fl0m0/EFM8_USB_Debug_Adapter/doc/bestellen.md

* Anschlussklemmen
  * Metz Connect [31230102](https://www.reichelt.de/index.html?ACTION=446&LA=3&nbc=1&q=31230102) und [31249102](https://www.reichelt.de/index.html?ACTION=446&LA=446&nbc=1&q=31249102)
* Magnet: https://www.reichelt.de/magnete-c7619.html?&nbc=1
* Hohlstecker [DELOCK 89910](https://www.reichelt.de/steckverbinder-dc-buchse-zum-einbau-delock-89910-p259482.html?&trstct=pol_7&nbc=1)
* Wannenstecker

  * [WSL 10W](https://www.reichelt.de/wannenstecker-10-polig-gewinkelt-wsl-10w-p22818.html?&trstct=pos_0&nbc=1)

  * [WSL 6W](https://www.reichelt.de/wannenstecker-6-polig-gewinkelt-wsl-6w-p105978.html?search=wsl6w)
* Jumper [BKL 10120906](https://www.reichelt.de/kodierbruecken-set-blau-schwarz-rot-bkl-10120906-p235670.html?&trstct=pol_4&nbc=1)
* Stiftleiste 36-polig [W+P 946-14-036](https://www.reichelt.de/stiftleiste-rm-2-54mm-gewinkelt-1-reihig-36-polig-w-p-946-14-036-p330986.html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)
* Crimpzange
  * Iwiss 3220M
  * Für Aderendhülsen
  * Crimpkontakte
* Lötpaste, z.B. Chipquick [TS391SNL10](https://www.digikey.de/de/products/detail/chip-quik-inc/TS391SNL10/7802216) (bei Raumtemperatur lagerbar)
* [USB-Stick](https://www.reichelt.de/usb-stick-usb-3-1-128-gb-ultra-fit-sdcz430-128g-g46-p222575.html?&trstct=pos_27&nbc=1) für Fritz!Box
* [Thermo- / Hygrometer](https://www.reichelt.de/thermo-hygrometer-tfa-30505102-p288520.html?&trstct=pos_17&nbc=1)
* [UJC-HP-G-5-SMT-TR](https://www.cuidevices.com/product/interconnect/connectors/usb-connectors/ujc-hp-g-5-smt-tr), besser[USB4135-GF-A](https://www.digikey.de/en/products/detail/gct/USB4135-GF-A/16036137) da lieferbar
* BNC-Kabel
  * [T-Stück](https://www.reichelt.de/adapter-bnc-t-stueck-50-ohm-bkl-0401169-p280451.html?&trstct=pos_23&nbc=1)
  * [Terminalblock](https://www.reichelt.de/bnc-stecker-terminalblock-2-pin-delock-65525-p143220.html?&trstct=pos_9&nbc=1)
  * [BNC-Stecker-Kappe](https://www.reichelt.de/bnc-stecker-kappe-ohne-kette-r141-802-p120895.html?&trstct=pol_4&nbc=1)
  * [BNC-Adapter](https://www.reichelt.de/bnc-adapter-bnc-stecker-2x-polklemme-ge-860-p8153.html?&trstct=pol_31&nbc=1)
  * [50 Ohm](https://www.reichelt.de/bnc-abschlussstecker-50-ohm-ug-88-50-p22035.html?&nbc=1&trstct=lsbght_sldr::8153)
  * [9 V Block](https://www.reichelt.de/hycell-nimh-akku-9-v-block-180-mah-1er-pack-ans-hc-9v-180-p334542.html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)
  *
