fl0m0/EFM8_USB_Debug_Adapter/doc/Design_Notes_B1.md

* Improved ideal diode from https://hardware.buspirate.com/#programmable-power-supply-unit
* Isolated communication interface
  * [ADuM1253](https://www.analog.com/media/en/technical-documentation/data-sheets/adum1253.pdf) for C2 interface
  * [ADuM5211](https://www.analog.com/media/en/technical-documentation/data-sheets/ADuM5210_5211_5212.pdf) for UART
  * 

* UART RX/TX LED indicator
