fl0m0/EFM8_USB_Debug_Adapter/mech/Case/USB_CON_Light_Pipe.step

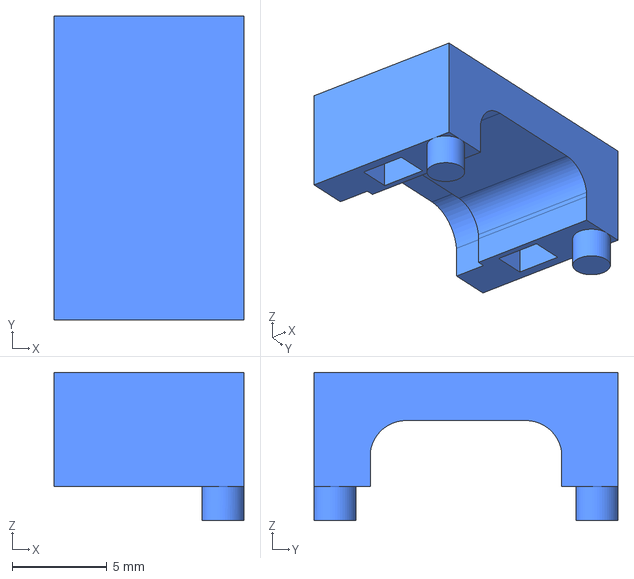
[picture p1: CAD file, 2024-02-17]
mech/Case/USB_CON_Light_Pipe.step
10.0 x 16.0 x 7.80 mm
