fl0m0/EFM8_USB_Debug_Adapter/mech/Case/EFM8_USB_Debug_Adapter_Case_A1.FCStd

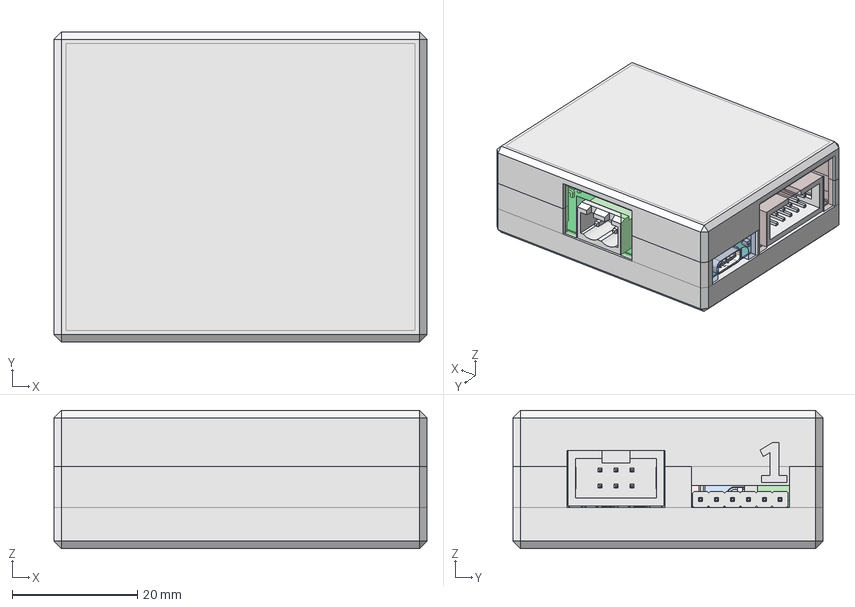
[picture p3: CAD file, 2024-02-17]
mech/Case/EFM8_USB_Debug_Adapter_Case_A1.FCStd
59.6 x 49.6 x 22.1 mm
Pcb_1969
J100_IDC_Header_2x03_P254mm_Horizontal_0b07955c75c3
R115_R_0603_1608Metric_40ce69eb2c34 x 14
D120_LED_0805_2012Metric_de8e61f5e2f3 x 6
M130_DBG8 CON - Body002_e8fd90211a46
Q121_SOT_23_6_8a3c9792cae7 x 6
J130_IDC_Header_2x05_P254mm_Horizontal_2f630b54ad9b
J111_PinHeader_1x06_P254mm_Horizontal_3895f87b3638
M110_USB CON - Body004_d89be29e0cf2
J120_MSTBA_01x02_G_5_08mm_f78722a1ad4a
F110_Fuse_1206_3216Metric_44d931e7ee9a
M120_PSU CON - Body003_f36d153cdec4
J131_PinHeader_1x02_P254mm_Vertical_49238c3e1f2a
Bottom - Body
Top - Body001
