fl0m0/EFM8_USB_Debug_Adapter/mech/Case/EFM8_USB_Debug_Adapter_Case_A1-PartBottom.stl

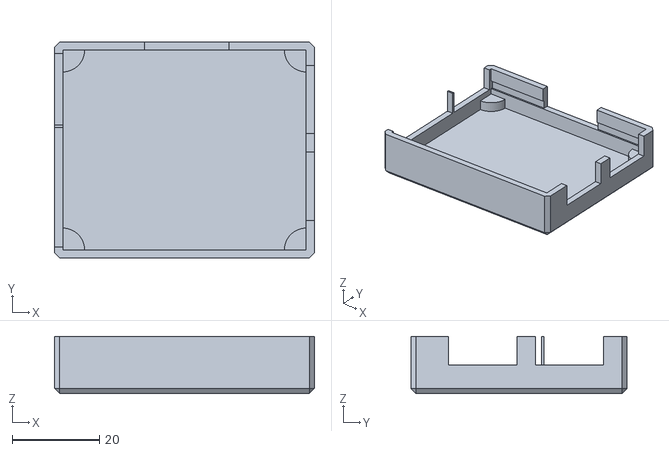
[picture p4: CAD file, 2024-02-17]
mech/Case/EFM8_USB_Debug_Adapter_Case_A1-PartBottom.stl
59.6 x 49.6 x 13.1
