fl0m0/EFM8_USB_Debug_Adapter/mech/Case/EFM8_Light_Pipes.3mf

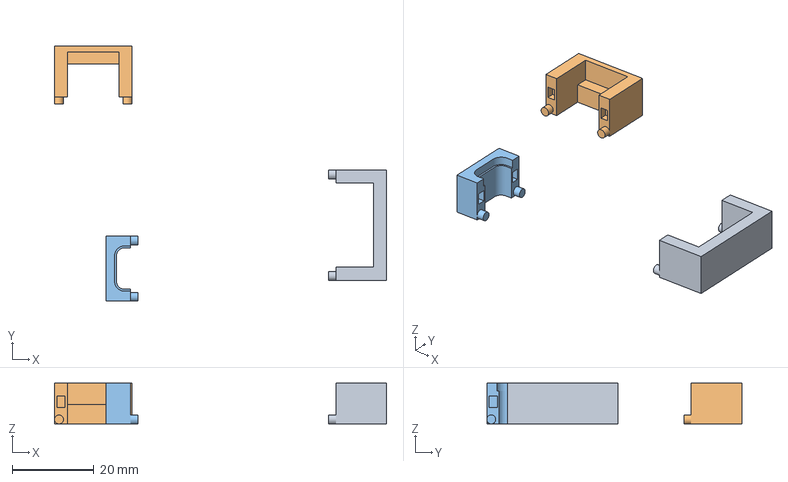
[picture p5: CAD file, 2024-02-17]
mech/Case/EFM8_Light_Pipes.3mf
81.3 x 62.5 x 10.0 mm
DBG8_CON_Light_Pipe.stl
PSU_CON_Light_Pipe.stl
USB_CON_Light_Pipe.stl
