fl0m0/EFM8_USB_Debug_Adapter/mech/Case/PSU_CON_Light_Pipe.step

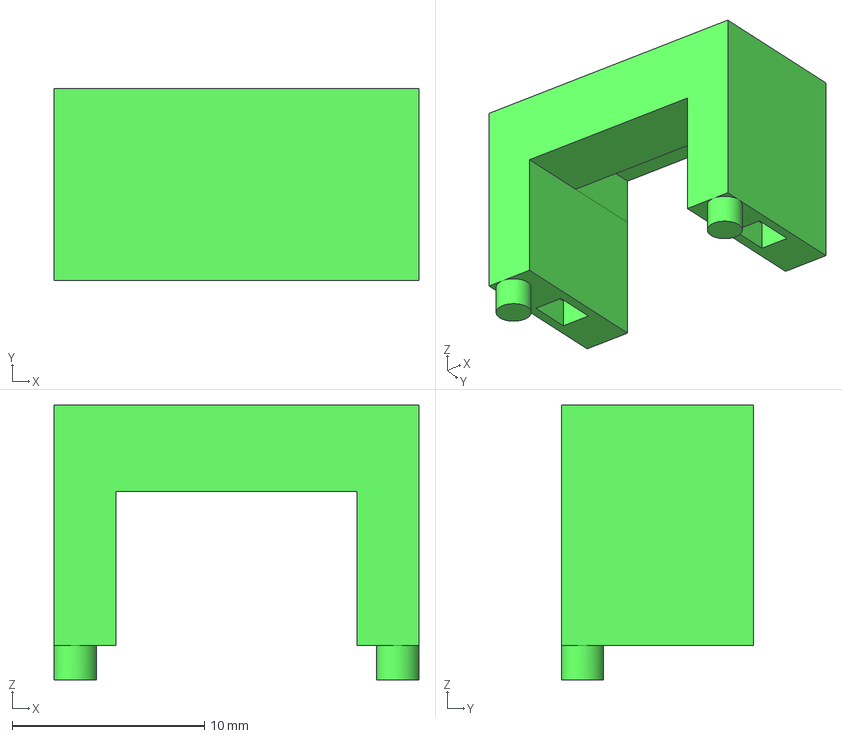
[picture p6: CAD file, 2024-02-17]
mech/Case/PSU_CON_Light_Pipe.step
19.0 x 10.0 x 14.3 mm
