fl0m0/EFM8_USB_Debug_Adapter/mech/Case/DBG8_CON_Light_Pipe.step

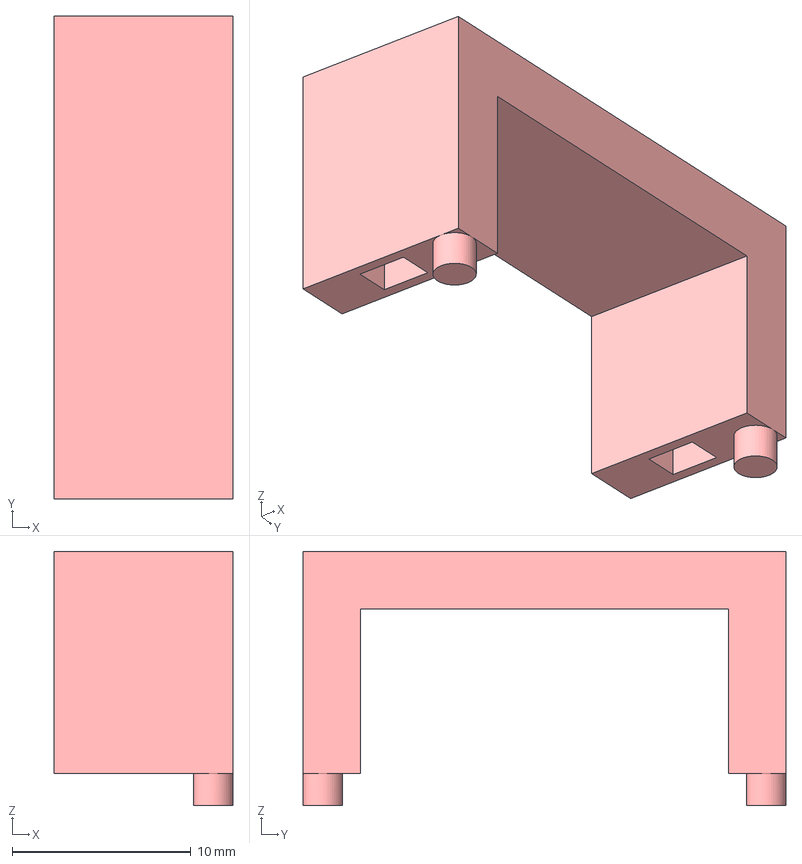
[picture p8: CAD file, 2024-02-17]
mech/Case/DBG8_CON_Light_Pipe.step
10.0 x 27.0 x 14.2 mm
