fl0m0/EFM8_USB_Debug_Adapter/mech/Case/EFM8_USB_Debug_Adapter_Case_A1-Logo.stl

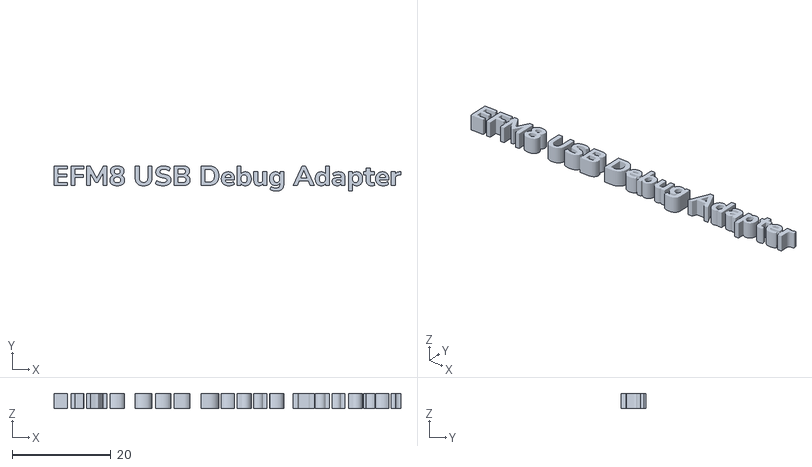
[picture p9: CAD file, 2024-02-17]
mech/Case/EFM8_USB_Debug_Adapter_Case_A1-Logo.stl
70.2 x 5.10 x 3.00
