fl0m0/EFM8_USB_Debug_Adapter/mech/Case/3D_31249102_1.stp

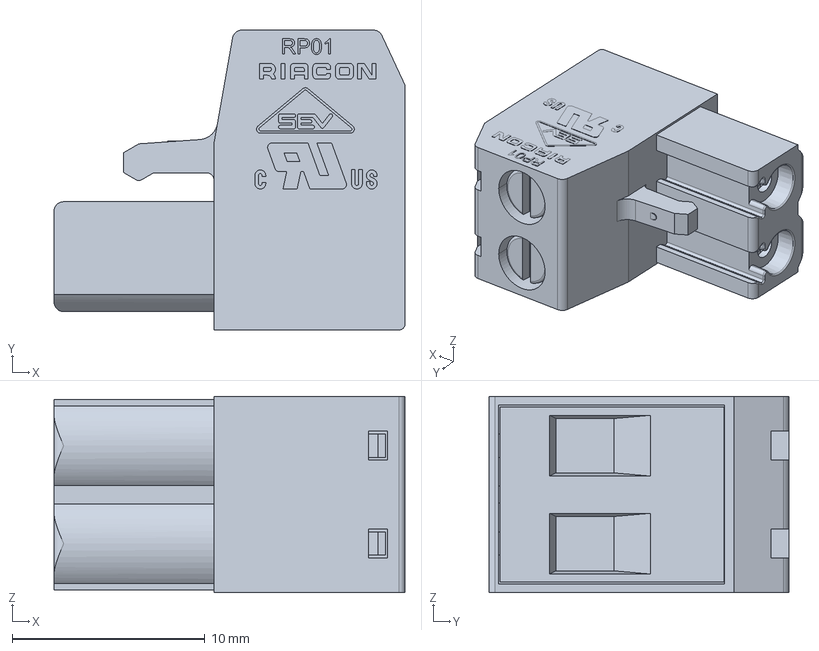
[picture p10: CAD file, 2022-11-03]
mech/Case/3D_31249102_1.stp
18.2 x 15.6 x 10.2 mm
