fl0m0/EFM8_USB_Debug_Adapter/(list of files, cad)

Other CAD files:
mech/Case/DBG8_CON_Light_Pipe.dxf
mech/Case/DBG8_CON_Light_Pipe.stl
mech/Case/EFM8_USB_Debug_Adapter_Case_A1.3mf
mech/Case/PSU_CON_Light_Pipe.dxf
mech/Case/PSU_CON_Light_Pipe.stl
mech/Case/USB_CON_Light_Pipe.dxf
mech/Case/USB_CON_Light_Pipe.stl
