fl0m0/EFM8_USB_Debug_Adapter/pcb/EFM8_USB_Debug_Adapter/B1/fabrication_output/EFM8_USB_Debug_Adapter.pdf

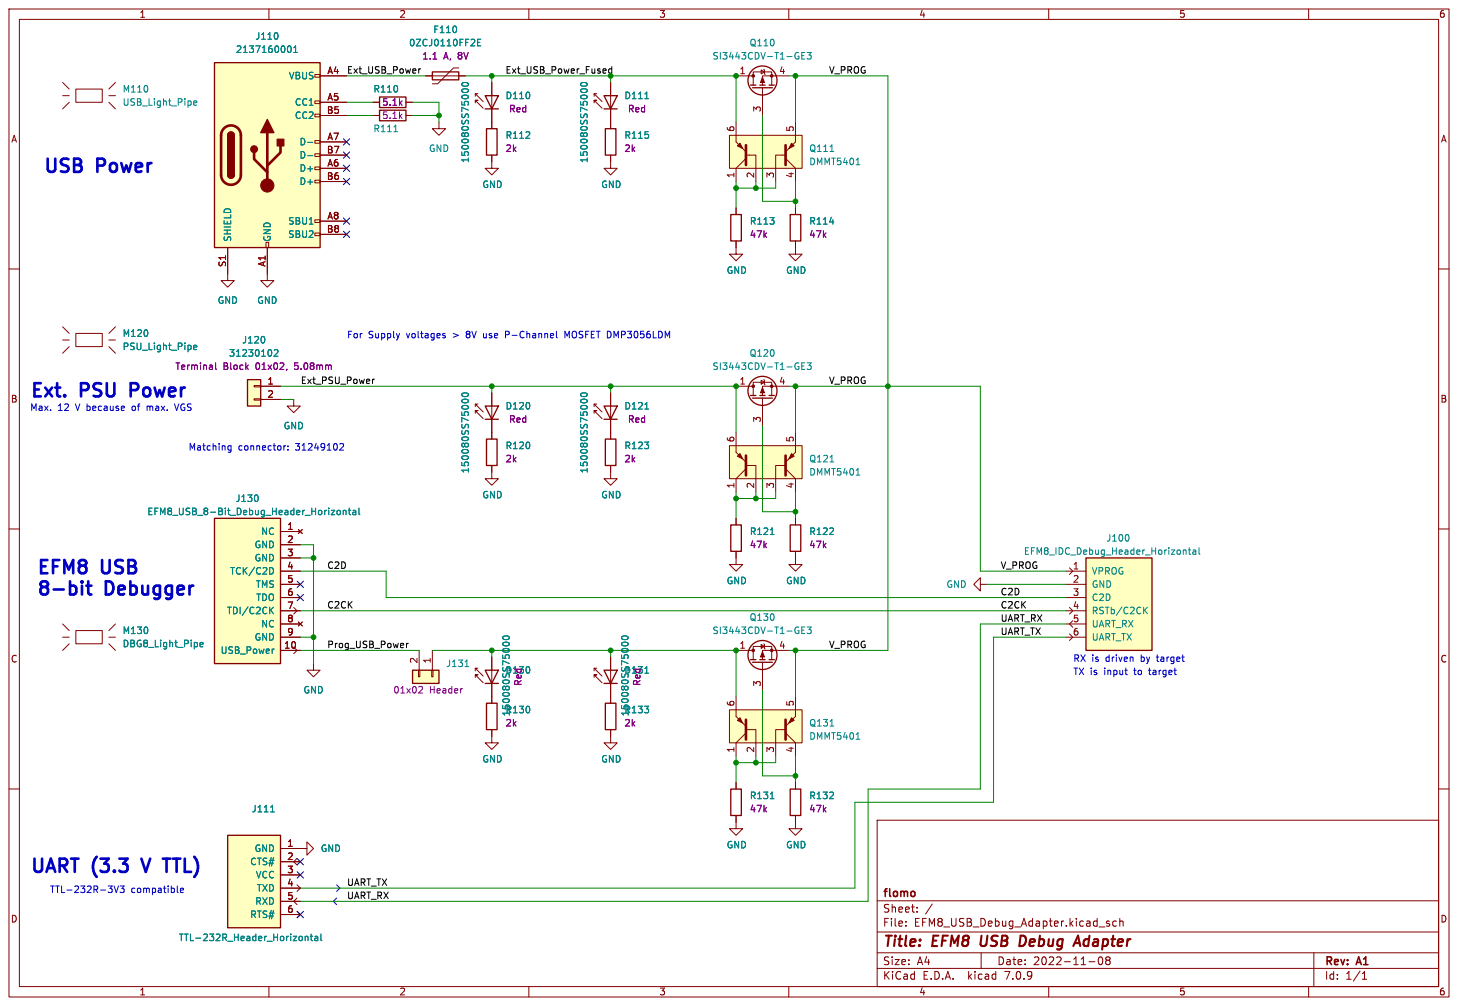
[picture p11: page 1]

TX is input to target RX is driven by target USB Power

Ext. PSU Power
Max. 12 V because of max. VGS

Id: 1/1 Title: EFM8 USB Debug Adapter File: EFM8_USB_Debug_Adapter.kicad_sch Sheet: / flomo
