fl0m0/EFM8_USB_Debug_Adapter/sim/Ideal_Diode/Current_Mirror.asc

D1: diode; 1N4148
Q1: pnp; BC857B
Q2: pnp; BC857B
R1: res; 75k
R2: res; 100k
R3: res; 1m
R4: res; 1m
R5: res; 10k
V1: voltage; 10
V2: voltage; PWL(0 10 1m 10 1.1m 10.01 2m 10.01 2.1m 9.99 3m 9.99 3.1m 10)
Named nets: 0, base, v1, out, v2, e1, e2
.tran 4m
From https://hardware.buspirate.com/#programmable-power-supply-unit
R1 R2 imbalance makes the circuit more sensitive to a higher V2.
R5 decouples both transistors.
D1 protects Q1 from reverse BE voltage.
