fl0m0/EFM8_USB_Debug_Adapter/sim/Ideal_Diode/Ideal_Diode.asc

D1: diode; 1N4148
M1: pmos; Si4431DY
Q1: pnp; BC857B
Q2: pnp; BC857B
R1: res; 75k
R2: res; 100k
R4: res; 1k
V1: voltage; 10
V2: voltage; PULSE(0 20 10m 1m 1m 100m 200m)
Named nets: 0, in, base, out, gate
.tran 250m
