fl0m0/EFM8_USB_Debug_Adapter/pcb/EFM8_USB_Debug_Adapter/B1/EFM8_USB_Debug_Adapter.kicad_pcb

## KiCad design pcb/EFM8_USB_Debug_Adapter/B1/EFM8_USB_Debug_Adapter.kicad_pcb (2024-03-22)

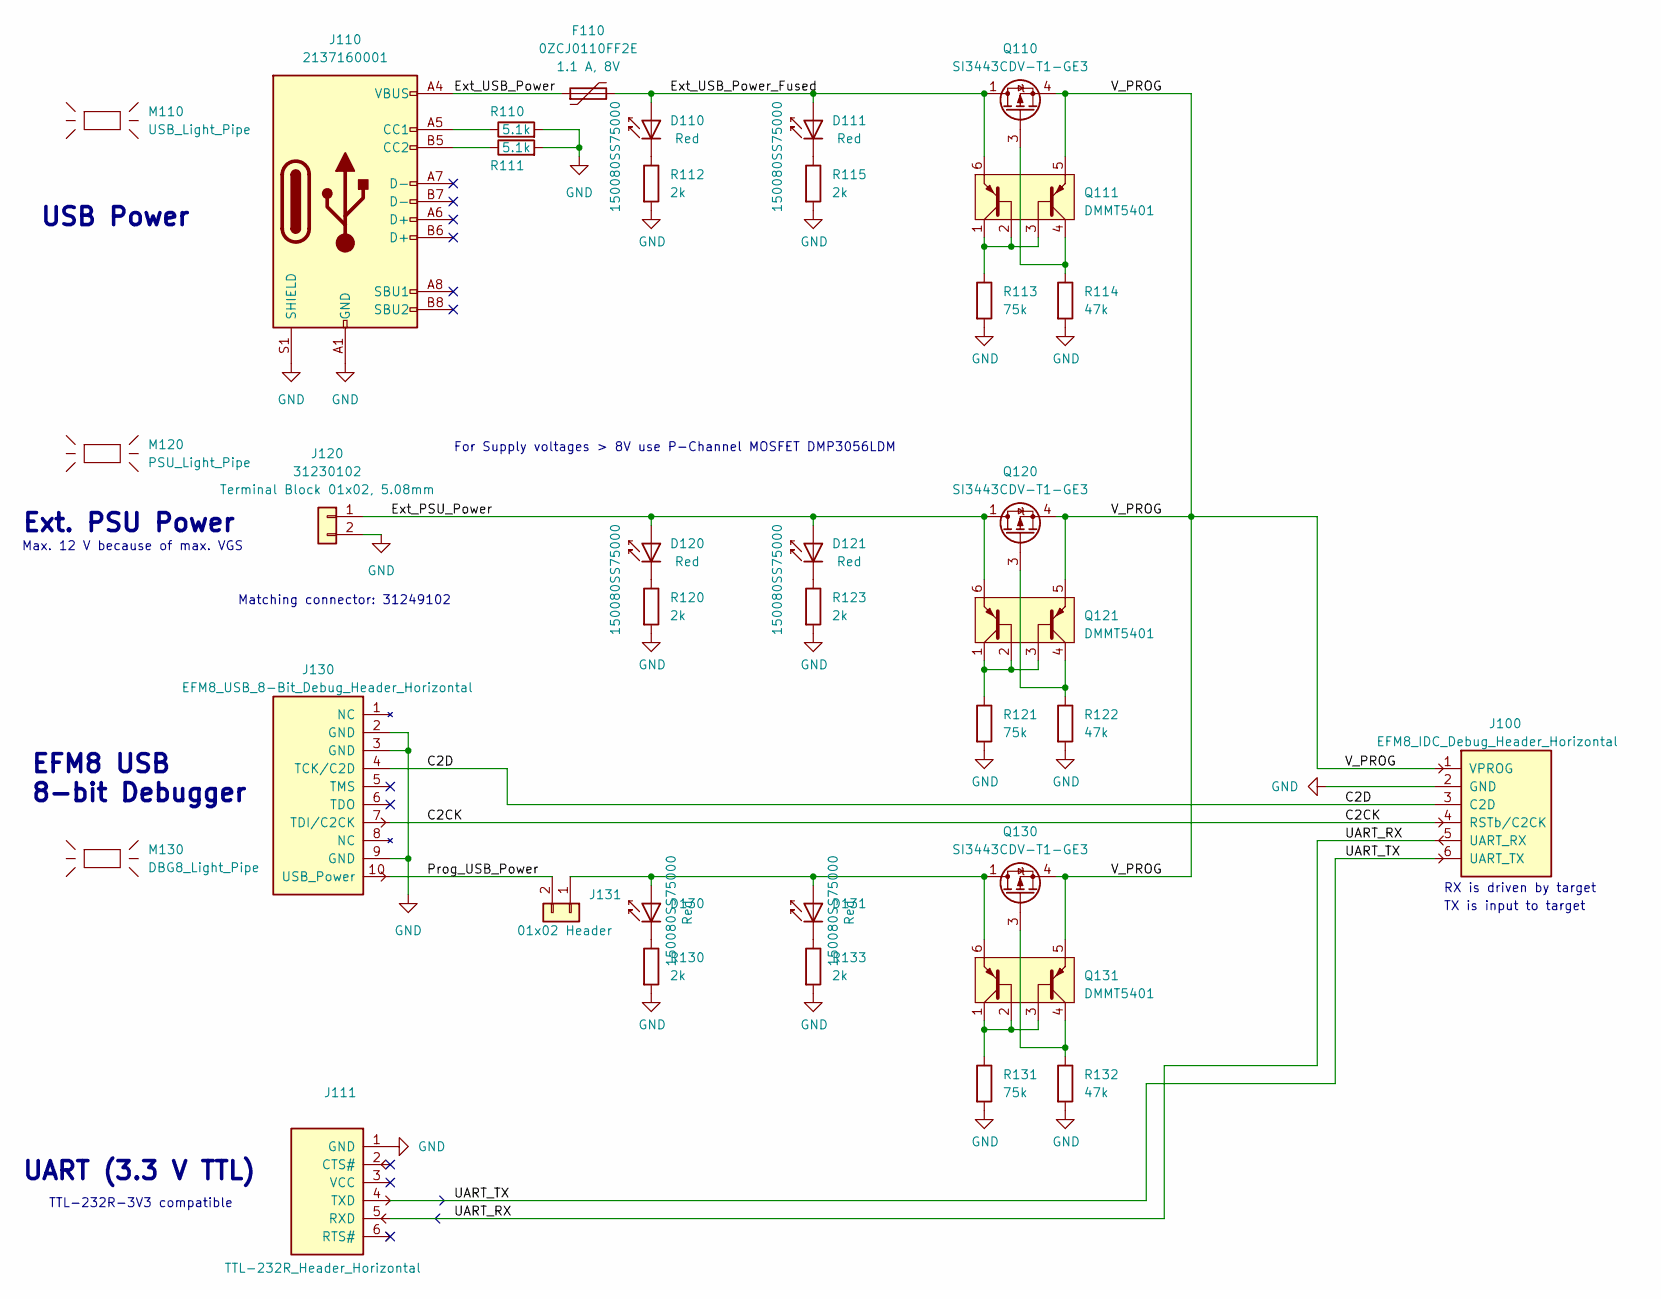
[picture p12: schematic Connectors.kicad_sch]

Parts:
D110, D111, D120, D121, D130, D131: 150080SS75000; LED_0805_2012Metric_Pad1.15x1.40mm_HandSolder
F110: 0ZCJ0110FF2E; Fuse_1206_3216Metric_Pad1.42x1.75mm_HandSolder
J100: EFM8_IDC_Debug_Header_Horizontal; IDC-Header_2x03_P2.54mm_Horizontal_61200621721; MPN 61200621721
J110: 2137160001; USB_C_Receptacle_Molex_2137160001
J111: TTL-232R_Header_Horizontal; PinHeader_1x06_P2.54mm_Horizontal; MPN 61300611021
J120: 31230102; PhoenixContact_MSTBA_2,5_2-G-5,08_1x02_P5.08mm_Horizontal; MPN 31230102
J130: EFM8_USB_8-Bit_Debug_Header_Horizontal; IDC-Header_2x05_P2.54mm_Horizontal_61201021721; MPN 61201021721
J131: Header_01x02_Wurth_61300211121; PinHeader_1x02_P2.54mm_Vertical; MPN 61300211121
M110: USB_Light_Pipe; USB_CON_Light_Pipe
M120: PSU_Light_Pipe; PSU_CON_Light_Pipe
M130: DBG8_Light_Pipe; DBG8_CON_Light_Pipe
Q110, Q120, Q130: SI3443CDV-T1-GE3; SOT-23-6_Handsoldering
Q111, Q121, Q131: DMMT5401; SOT-23-6_Handsoldering; MPN DMMT5401-7-F
R110, R111: 5.1k,0603; R_0603_1608Metric_Pad0.98x0.95mm_HandSolder; Tolerance 1%
R112, R115, R120, R123, R130, R133: 2k,0603; R_0603_1608Metric_Pad0.98x0.95mm_HandSolder; Tolerance 1%
R113, R121, R131: 75k,0603; R_0603_1608Metric_Pad0.98x0.95mm_HandSolder; Tolerance 1%
R114, R122, R132: 47k,0603; R_0603_1608Metric_Pad0.98x0.95mm_HandSolder; Tolerance 1%

Connections:
/Connectors/C2CK: J100.4 (RSTb/C2CK), J130.7 (TDI/C2CK)
/Connectors/C2D: J100.3 (C2D), J130.4 (TCK/C2D)
/Connectors/Ext_PSU_Power: D120.2 (A), D121.2 (A), J120.1, Q120.1 (D), Q120.2 (D), Q120.5 (D), Q120.6 (D), Q121.6 (E1)
/Connectors/Ext_USB_Power: F110.1, J110.A4 (VBUS), J110.A9 (VBUS), J110.B4 (VBUS), J110.B9 (VBUS)
/Connectors/Ext_USB_Power_Fused: D110.2 (A), D111.2 (A), F110.2, Q110.1 (D), Q110.2 (D), Q110.5 (D), Q110.6 (D), Q111.6 (E1)
/Connectors/Prog_USB_Power: J130.10 (USB_Power), J131.2
/Connectors/UART_RX: J100.5 (UART_RX), J111.5 (RXD)
/Connectors/UART_TX: J100.6 (UART_TX), J111.4 (TXD)
/Connectors/V_PROG: J100.1 (VPROG), Q110.4 (S), Q111.5 (E2), Q120.4 (S), Q121.5 (E2), Q130.4 (S), Q131.5 (E2)
GND: J100.2 (GND), J110.A1 (GND), J110.A12 (GND), J110.B1 (GND), J110.B12 (GND), J110.S1 (SHIELD), J111.1 (GND), J120.2, J130.2 (GND), J130.3 (GND), J130.9 (GND), R110.2, R111.2, R112.2, R113.2, R114.2, R115.2, R120.2, R121.2, R122.2, R123.2, R130.2, R131.2, R132.2, R133.2
unnamed: D110.1 (K), R112.1
unnamed: D111.1 (K), R115.1
unnamed: D120.1 (K), R120.1
unnamed: D121.1 (K), R123.1
unnamed: D130.2 (A), D131.2 (A), J131.1, Q130.1 (D), Q130.2 (D), Q130.5 (D), Q130.6 (D), Q131.6 (E1)
unnamed: D130.1 (K), R130.1
unnamed: D131.1 (K), R133.1
unnamed: J110.A5 (CC1), R110.1
unnamed: J110.B5 (CC2), R111.1
unnamed: Q110.3 (G), Q111.4 (C2), R114.1
unnamed: Q111.1 (C1), Q111.2 (B1), Q111.3 (B2), R113.1
unnamed: Q120.3 (G), Q121.4 (C2), R122.1
unnamed: Q121.1 (C1), Q121.2 (B1), Q121.3 (B2), R121.1
unnamed: Q130.3 (G), Q131.4 (C2), R132.1
unnamed: Q131.1 (C1), Q131.2 (B1), Q131.3 (B2), R131.1

Notes on the sheet:
TTL-232R-3V3 compatible
Ext. PSU Power
UART (3.3 V TTL)
EFM8 USB 8-bit Debugger
TX is input to target
USB Power
Max. 12 V because of max. VGS
Matching connector: 31249102
RX is driven by target
For Supply voltages > 8V use P-Channel MOSFET DMP3056LDM

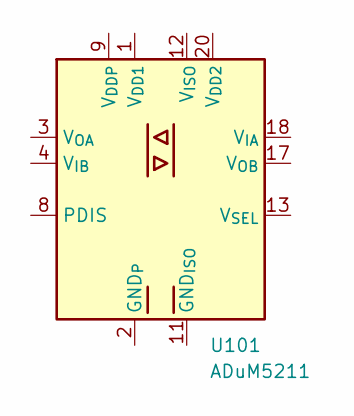
[picture p13: schematic Isolation.kicad_sch]

Parts:
U101: ADuM5211; SSOP-20_5.3x7.2mm_P0.65mm

Connections:
unnamed: U101.2 (GND_{P}), U101.5 (GND_{P}), U101.6 (GND_{P}), U101.10 (GND_{P})
unnamed: U101.11 (GND_{ISO}), U101.15 (GND_{ISO}), U101.16 (GND_{ISO}), U101.19 (GND_{ISO})

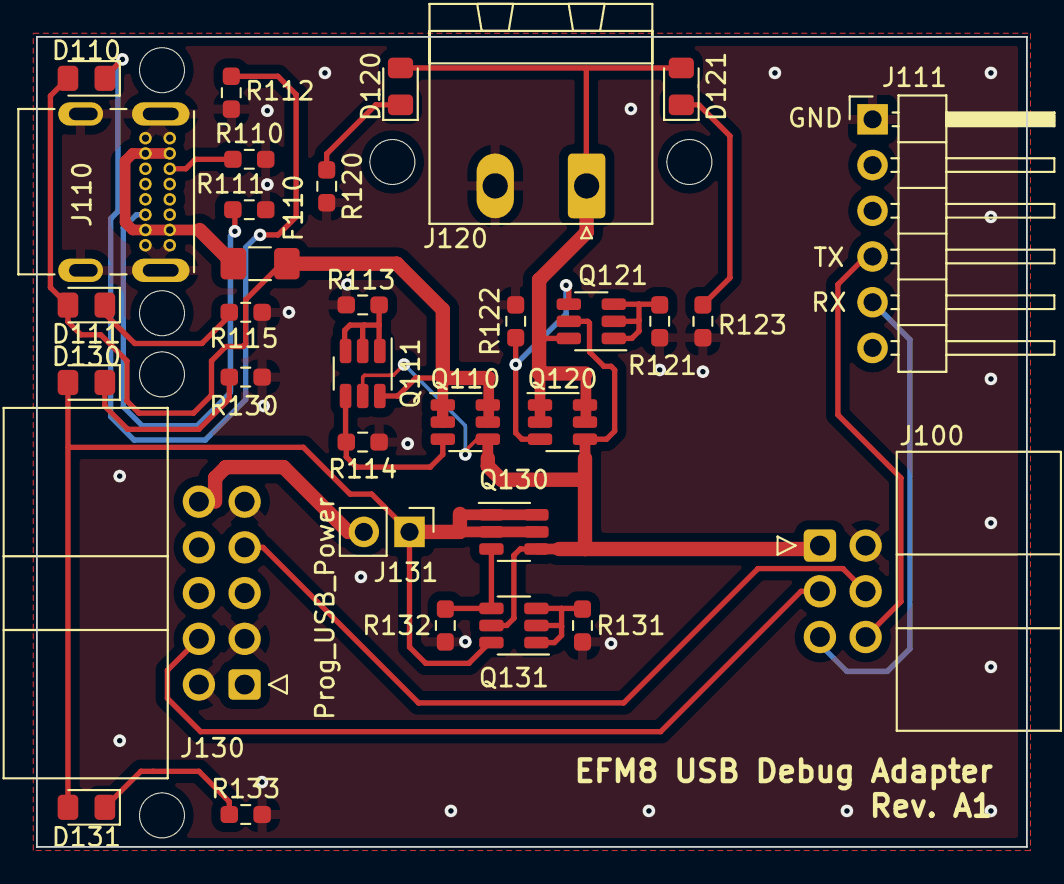
[picture p14: board EFM8_USB_Debug_Adapter.kicad_pcb from above]

Board: 2 copper layers, 55.0 x 45.0 mm, 36 parts (0 on the bottom side), 25 nets.
