fl0m0/EFM8_USB_Debug_Adapter/(commit log)

2022-10-23 Initialer Commit
    [EFM8_USB_Debug_Adapter.kicad_pcb, EFM8_USB_Debug_Adapter.kicad_sch]
2022-10-24 Erstes Layout
    [EFM8_USB_Debug_Adapter.kicad_pcb, EFM8_USB_Debug_Adapter.kicad_sch]
2022-10-26 PCB bearbeitet, FreeCAD Projet angelegt
    [EFM8_USB_Debug_Adapter.kicad_pcb, EFM8_USB_Debug_Adapter.kicad_sch, EFM8_USB_Debug_Adapter_Case.FCStd]
2022-10-28 Mechanik bearbeitet
    [EFM8_USB_Debug_Adapter.kicad_pcb, EFM8_USB_Debug_Adapter_Case.FCStd]
2022-10-29 Gehäuse bearbeitet
    [EFM8_USB_Debug_Adapter.kicad_sch, EFM8_USB_Debug_Adapter_Case.FCStd]
2022-10-31 Light Pipes in KiCad hinzugefügt
    [EFM8_USB_Debug_Adapter.kicad_pcb, EFM8_USB_Debug_Adapter.kicad_sch]
2022-10-31 USB Light Pipe bearbeitet
    [EFM8_USB_Debug_Adapter_Case.FCStd]
2022-11-03 PSU Stecker Light Pipe bearbeitet
    [3D_31249102_1.stp, EFM8_USB_Debug_Adapter_Case.FCStd]
2022-11-05 Lightpipes aktualisiert
    [EFM8_USB_Debug_Adapter.kicad_pcb, EFM8_USB_Debug_Adapter.kicad_sch, EFM8_USB_Debug_Adapter_Case.FCStd]
2022-11-06 PCB bearbeitet
    [EFM8_USB_Debug_Adapter.kicad_pcb, EFM8_USB_Debug_Adapter.kicad_sch]
2022-11-07 Stecker verschoben
    [EFM8_USB_Debug_Adapter.kicad_pcb]
2022-11-08 PCB Rev. A1
    [EFM8_USB_Debug_Adapter.kicad_pcb, EFM8_USB_Debug_Adapter.kicad_sch]
2022-11-09 Neues Case-Modell
    [EFM8_USB_Debug_Adapter_Case_A1.FCStd]
2024-02-17 Update to KiCad 7, add Cura projects
    [DBG8_CON_Light_Pipe.dxf, DBG8_CON_Light_Pipe.step, DBG8_CON_Light_Pipe.stl, EFM8_Light_Pipes.3mf, EFM8_USB_Debug_Adapter.csv, EFM8_USB_Debug_Adapter.kicad_sch, EFM8_USB_Debug_Adapter_Case.FCStd, EFM8_USB_Debug_Adapter_Case_A1-Logo.stl]
2024-02-17 Add pdf schematic
2024-03-22 Add new revision B1
    [Connectors.kicad_sch, EFM8_USB_Debug_Adapter.csv, EFM8_USB_Debug_Adapter.kicad_pcb, EFM8_USB_Debug_Adapter.kicad_sch, Isolation.kicad_sch]
2024-07-16 Update resistor values, LED colors
    [Connectors.kicad_sch, EFM8_USB_Debug_Adapter.kicad_sch]
